tluca04/optomechanical-laser-alignment-testbench/cad/parts/part for servo2base.SLDPRT

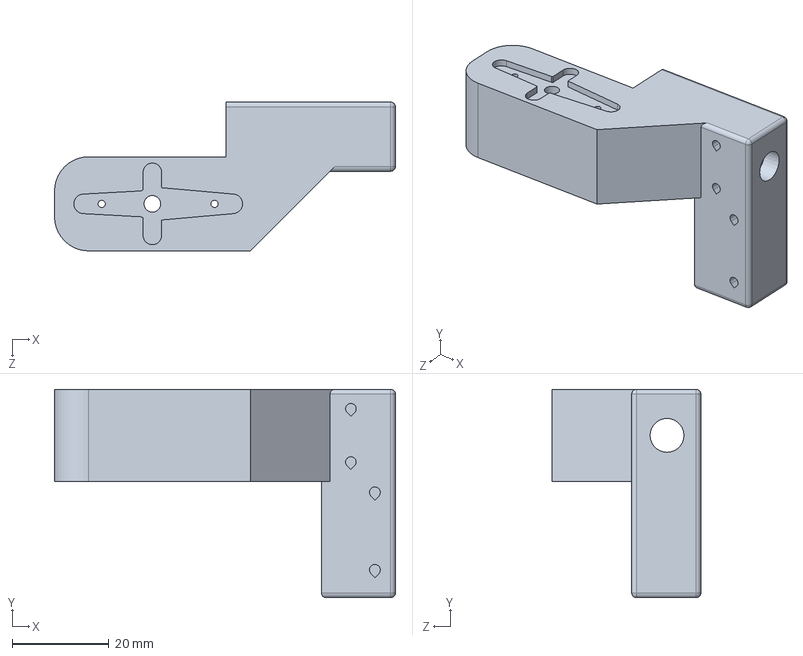
[picture p5: CAD file, 2026-11-03]
cad/parts/part for servo2base.SLDPRT
70.4 x 43.0 x 30.7 mm
