tluca04/optomechanical-laser-alignment-testbench/cad/parts/base 2 for servo 2 correct.SLDPRT

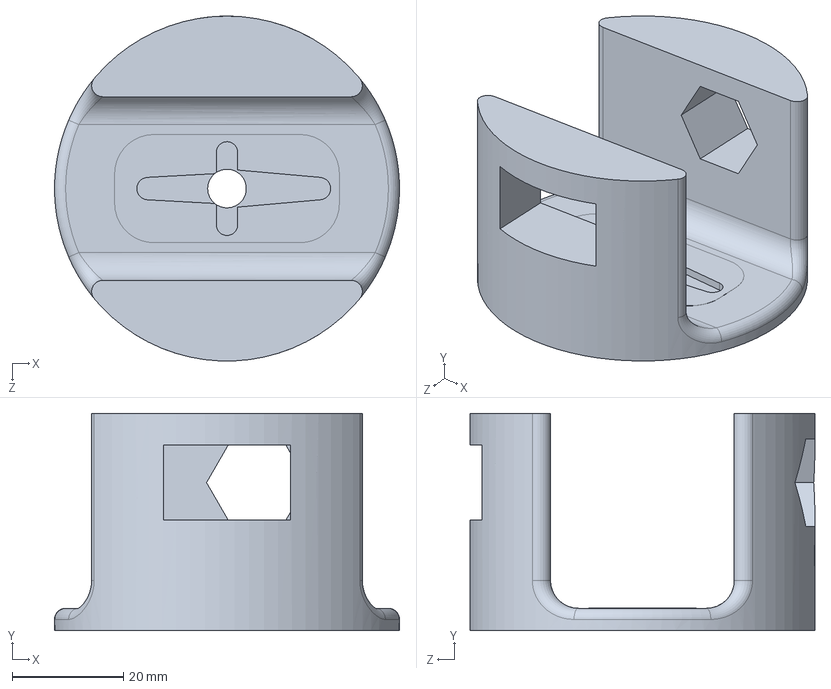
[picture p6: CAD file, 2026-11-03]
cad/parts/base 2 for servo 2 correct.SLDPRT
62.0 x 39.0 x 62.0 mm
