tluca04/optomechanical-laser-alignment-testbench/cad/parts/extension.SLDPRT

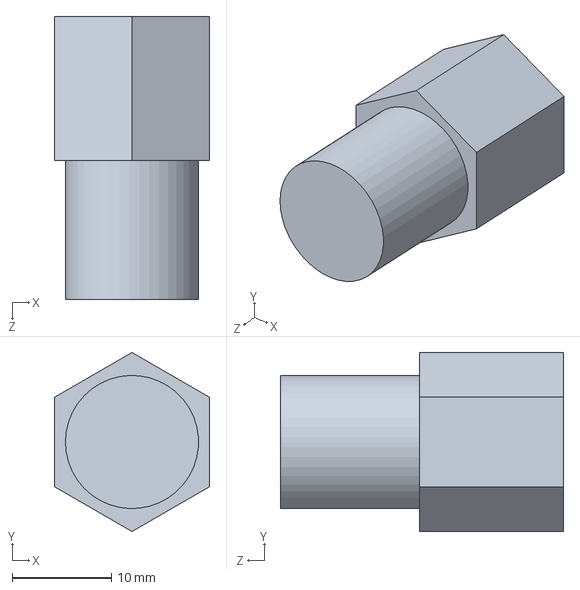
[picture p7: CAD file, 2026-11-03]
cad/parts/extension.SLDPRT
15.6 x 18.0 x 28.5 mm
