tluca04/optomechanical-laser-alignment-testbench/cad/parts/base 2 for servo 2 false.SLDPRT

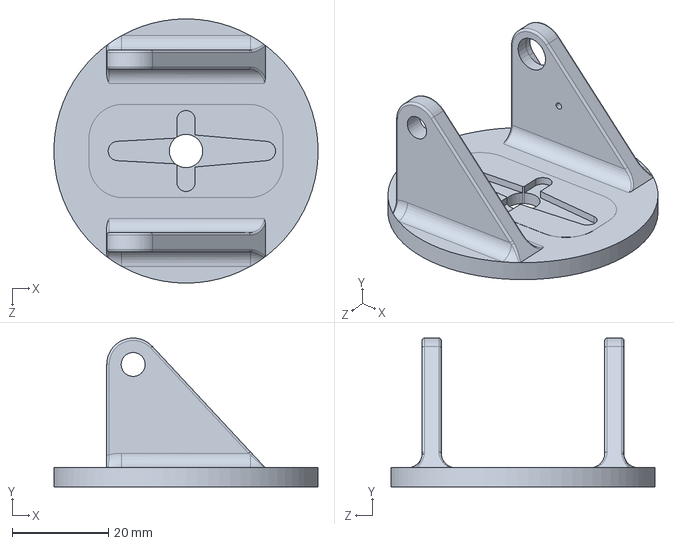
[picture p8: CAD file, 2026-10-29]
cad/parts/base 2 for servo 2 false.SLDPRT
55.0 x 31.0 x 55.0 mm
