tluca04/optomechanical-laser-alignment-testbench/cad/parts/part for base 2.SLDPRT

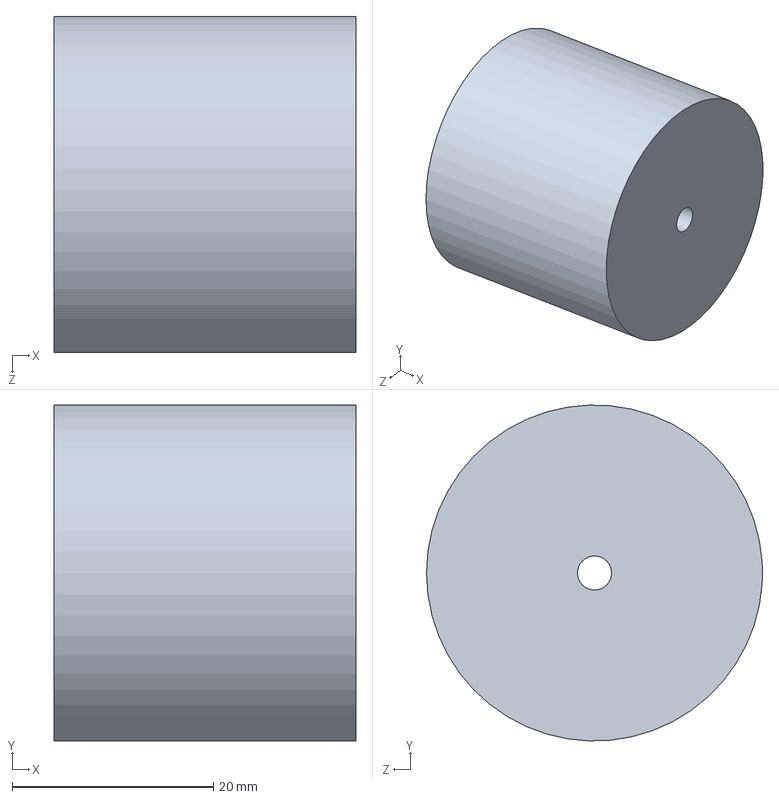
[picture p9: CAD file, 2026-10-29]
cad/parts/part for base 2.SLDPRT
30.0 x 33.4 x 33.4 mm
