tluca04/optomechanical-laser-alignment-testbench/cad/parts/base.SLDPRT

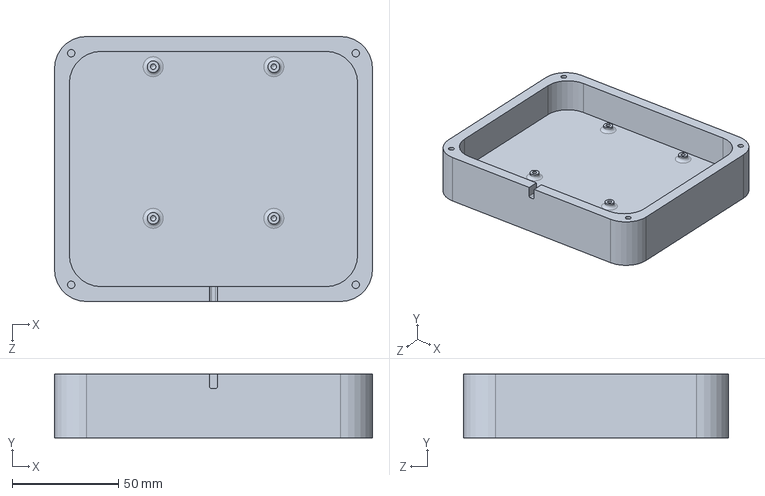
[picture p10: CAD file, 2026-10-25]
cad/parts/base.SLDPRT
150.0 x 30.0 x 125.0 mm
