tluca04/optomechanical-laser-alignment-testbench/cad/parts/base2.SLDPRT

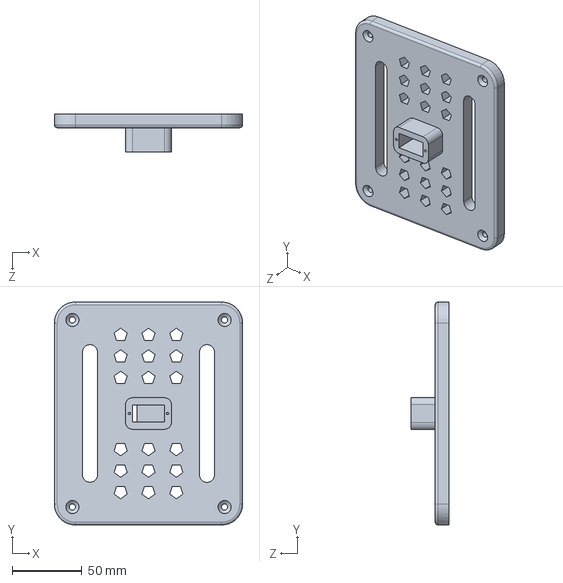
[picture p11: CAD file, 2026-10-25]
cad/parts/base2.SLDPRT
135.0 x 160.0 x 27.5 mm
