tluca04/optomechanical-laser-alignment-testbench/cad/cots/KY-008.STEP

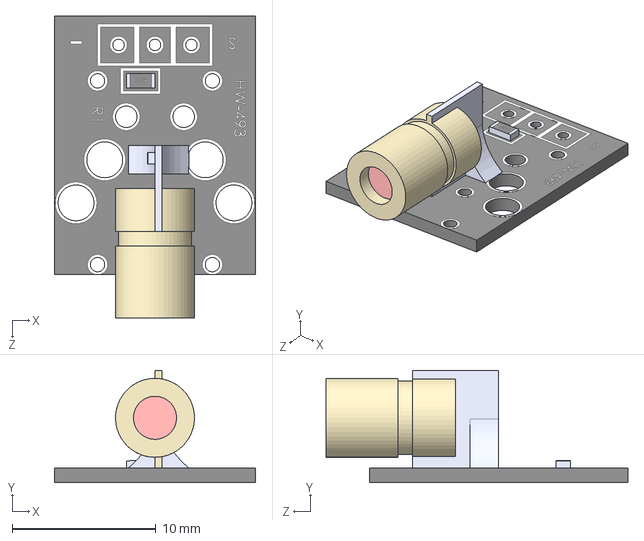
[picture p12: CAD file, 2026-10-29]
cad/cots/KY-008.STEP
14.0 x 7.81 x 21.0 mm
