tluca04/optomechanical-laser-alignment-testbench/cad/cots/AHT20+BMP280.step

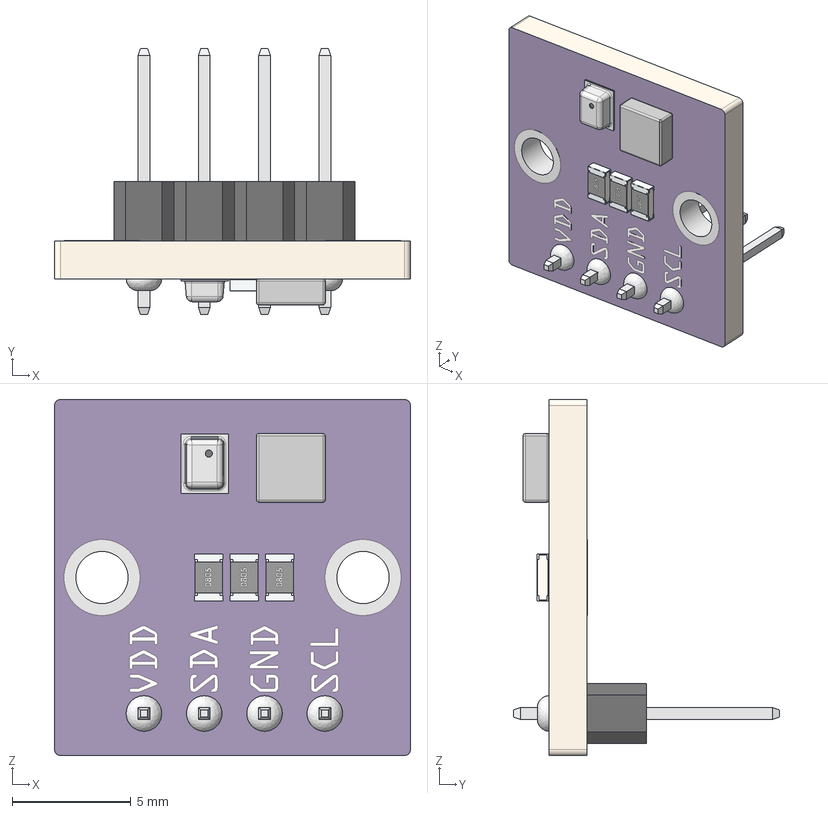
[picture p14: CAD file, 2026-10-10]
cad/cots/AHT20+BMP280.step
15.0 x 11.2 x 15.0 mm
Header Pins - Male x 4
SMD_0805 x 3
BMP280
