tluca04/optomechanical-laser-alignment-testbench/cad/cots/BH1750_with_connector.STEP

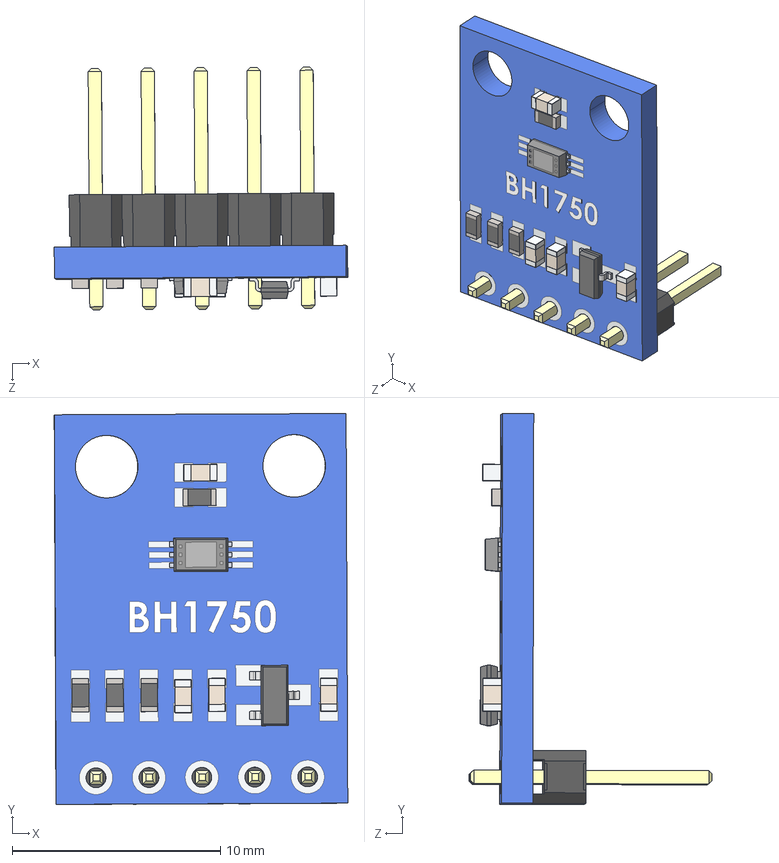
[picture p15: CAD file, 2026-10-10]
cad/cots/BH1750_with_connector.STEP
14.1 x 18.8 x 11.7 mm
r_0603 x 4
cap_0603 x 4
BH1750_board
BH1750
PLS-5
SOT-23-3
