tluca04/optomechanical-laser-alignment-testbench/cad/cots/INA219.step

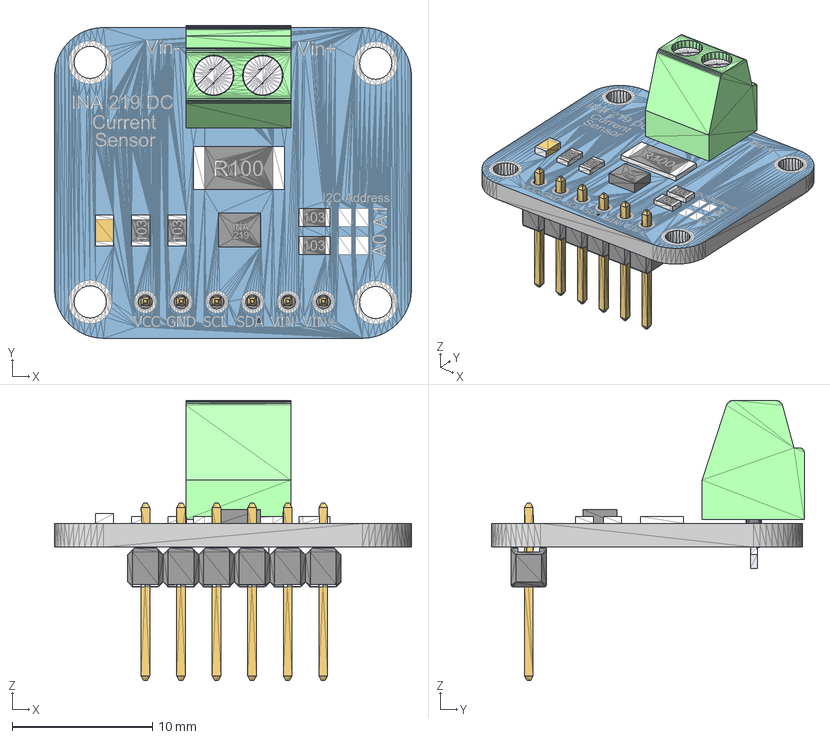
[picture p16: CAD file, 2026-10-10]
cad/cots/INA219.step
25.5 x 22.3 x 20.0 mm
