tluca04/optomechanical-laser-alignment-testbench/cad/cots/MPU_6050.step

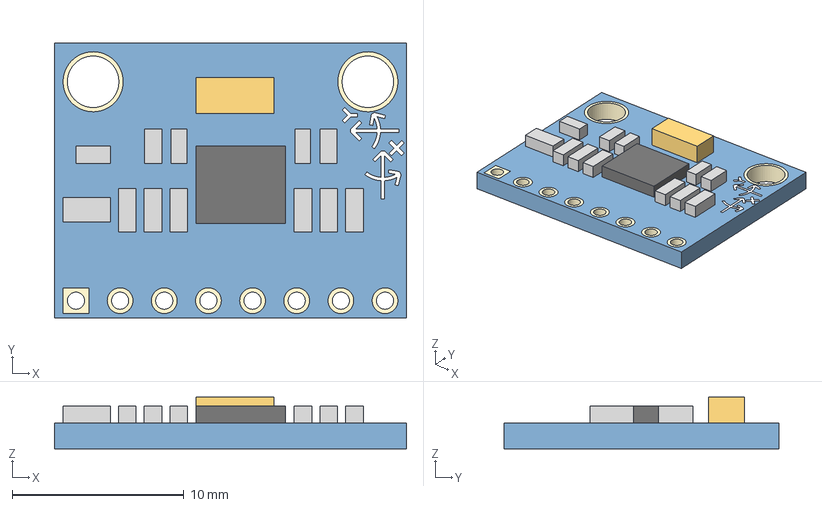
[picture p17: CAD file, 2026-10-10]
cad/cots/MPU_6050.step
20.5 x 16.0 x 3.00 mm
