tluca04/optomechanical-laser-alignment-testbench/cad/cots/ESP32 38 pin Screw terminal breakout board v11.step

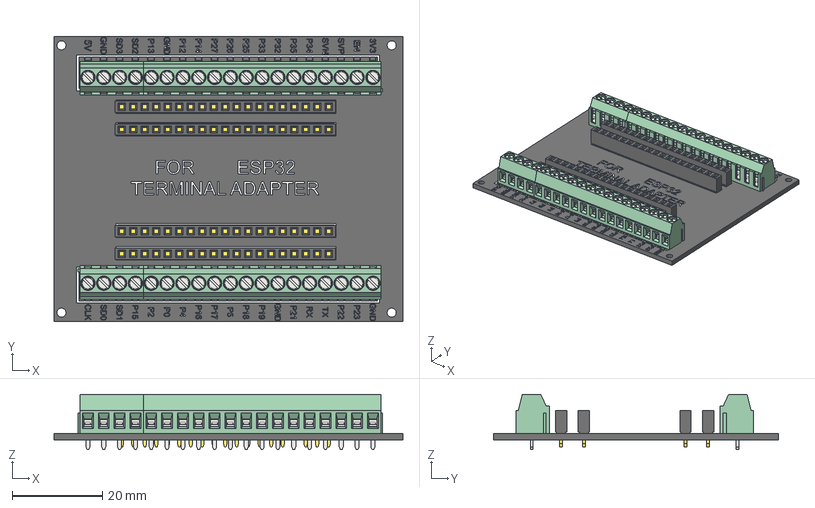
[picture p18: CAD file, 2026-10-10]
cad/cots/ESP32 38 pin Screw terminal breakout board v11.step
77.2 x 63.1 x 12.2 mm
19er Pin Header Female x 4
Plastic Housing013 x 2
Pin 014 x 2
Clamp Block013 x 2
M1.6x3-Screw013 x 2
Plastic Housing003 x 2
Pin 004 x 2
Clamp Block003 x 2
M1.6x3-Screw017 x 2
