tluca04/optomechanical-laser-alignment-testbench/cad/cots/SERVO_SG90.stp

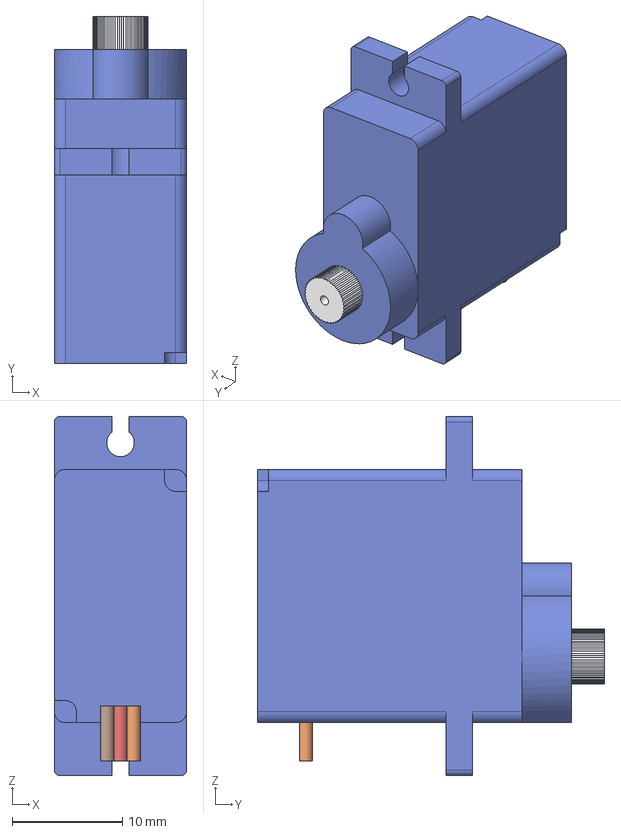
[picture p19: CAD file, 2026-10-10]
cad/cots/SERVO_SG90.stp
12.0 x 31.5 x 32.6 mm
