tluca04/optomechanical-laser-alignment-testbench/cad/assembly/assem.SLDASM

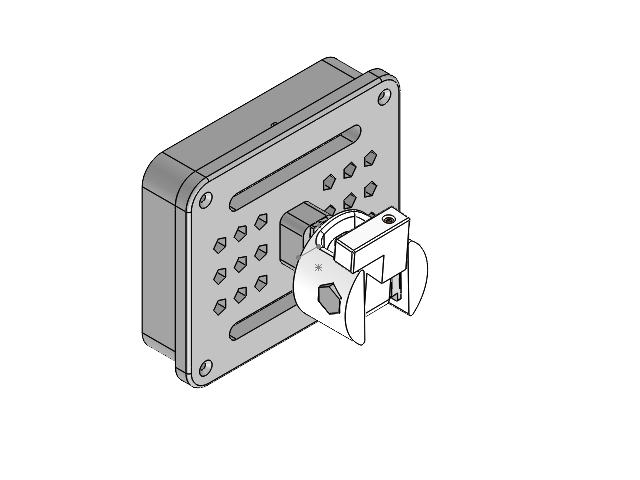
[picture p21: CAD file, 2026-11-03]
cad/assembly/assem.SLDASM
base
base2
SG90 - Micro Servo 9g - Tower Pro.1_Pe_a.STEP x 2
SG90 - Micro Servo 9g - Tower Pro.2_Pe_a.STEP x 2
SG90 - Micro Servo 9g - Tower Pro.3_Pe_a.STEP x 2
SG90 - Micro Servo 9g - Tower Pro.4_Pe_a.STEP x 2
SG90 - Micro Servo 9g - Tower Pro.5_BS EN ISO 7045 - M2 x 8 - Z - 8S.STEP x 4
SG90 - Micro Servo 9g - Tower Pro.6_BS EN ISO 7045 - M2 x 4 - Z - 4S.STEP x 2
KY-008.step
pcb.step
base 2 for servo 2 correct
part for servo2base
extension
