tluca04/optomechanical-laser-alignment-testbench/(list of files, cad)

Other CAD files:
cad/cots/AS5600_magnetic_encoder.step
cad/cots/PCB_ESP32-38Pines.step
