tluca04/optomechanical-laser-alignment-testbench/docs/testbench_setup.jpg.jpeg

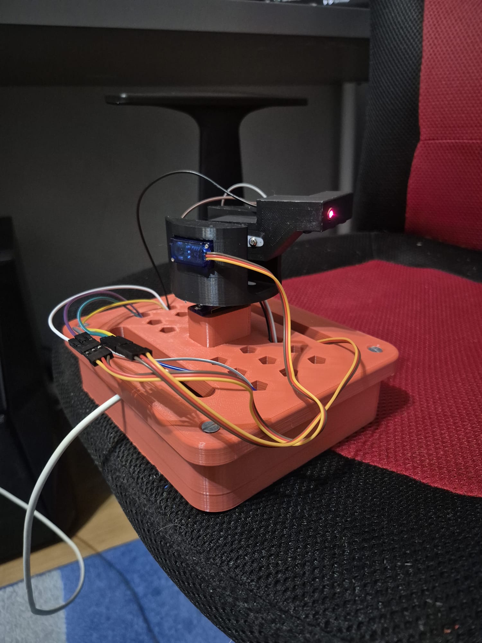
docs/testbench_setup.jpg.jpeg
