tluca04/optomechanical-laser-alignment-testbench/firmware/main/servo.h

#pragma once

#include "esp_err.h"
#include <stdint.h>
#include <stdbool.h>

#define SERVO_GPIO_PAN 25
#define SERVO_GPIO_TILT 26
#define SERVO_FREQ_HZ 50
#define SERVO_MIN_PULSE_US 500
#define SERVO_MAX_PULSE_US 2500
#define SERVO_PERIOD_US 20000
#define SERVO_MAX_ANGLE_DEG 180.0f
#define SERVO_MAX_STEPS 16384

typedef enum { SERVO_PAN = 0, SERVO_TILT = 1 } servo_axis_t;

esp_err_t servo_init(void);

esp_err_t servo_angle(servo_axis_t axis, float angle_degree);
