tluca04/optomechanical-laser-alignment-testbench/(commit log)

2026-10-08 initial testbench architecture and mpu6050 i2c driver
2026-10-10 cad cots added
    [AHT20+BMP280.step, AS5600_magnetic_encoder.step, BH1750_with_connector.STEP, ESP32 38 pin Screw terminal breakout board v11.step, INA219.step, LM2596.step, MPU_6050.step, PCB_ESP32-38Pines.step]
2026-10-10 added oled cad
    [SSD1306_OLED_Display(128x64).step]
2026-10-10 cad prototypes
    [assem.SLDASM, base.SLDPRT]
2026-10-12 more cad adjustments
2026-10-15 added servo code
2026-10-16 added servo control, telemetry plot and setup host
2026-10-18 optimized servo timing loop and update validation plot
2026-10-18 used vTaskDelayUntil for fixed 10ms sensor reads and updated cad base prototype
2026-10-19 added the second servo + alternative pan/tilt movements to limit current draw
2026-10-20 added UART driver and CMD parser for servo control from PC
2026-10-25 added other cad designs
2026-10-29 updated cad designs
2026-10-29 finished version of cad
2026-11-01 updated cad
2026-11-03 full assemby+wiring.md added
2026-11-03 real life assembly added
2026-11-05 added OpenCV laser tracking and centering
2026-11-05 Fix typo in sensors section of README.md
2026-11-05 readme update 2
    Updated instructions for flashing ESP32 and running scripts.
